blacksnake200212-del/FYP_2026/hardware_docs/sdas_corrected_circuit_schematic.jpg

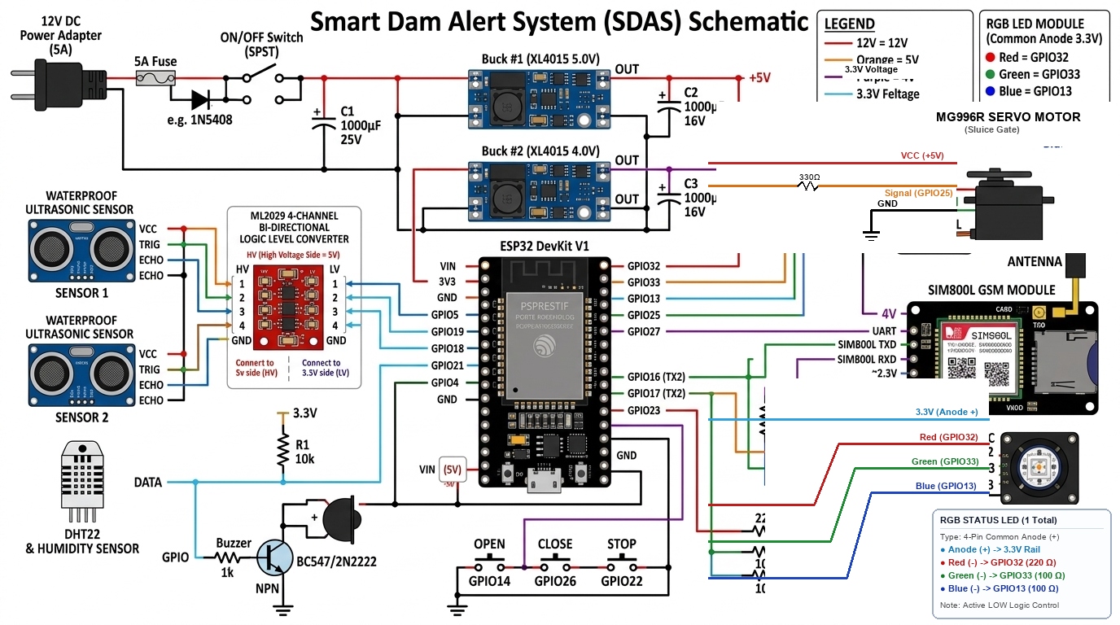
hardware_docs/sdas_corrected_circuit_schematic.jpg
