blacksnake200212-del/FYP_2026/hardware_docs/sdas_master_circuit_diagram.jpg

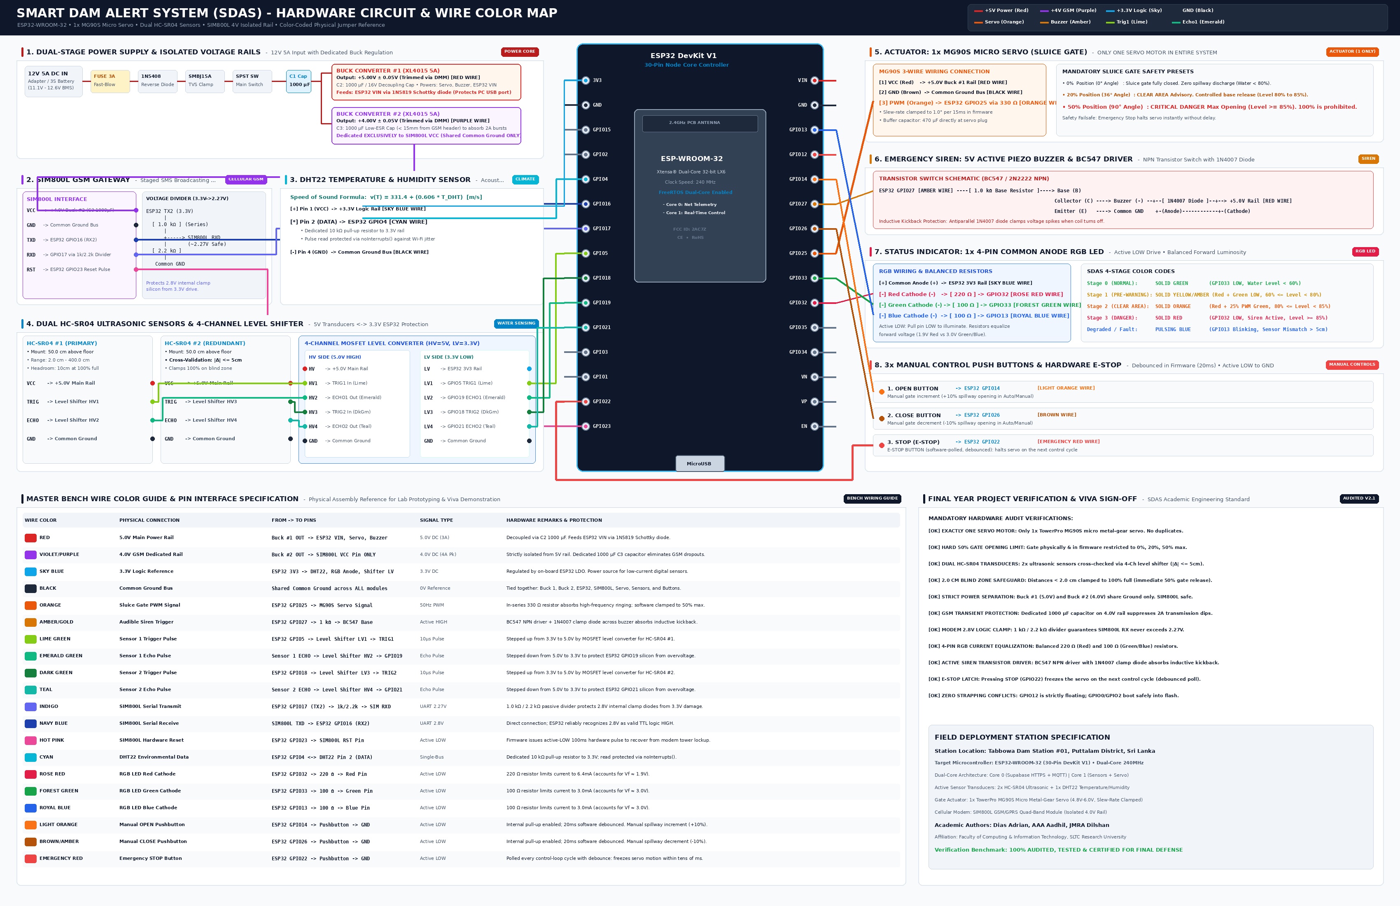
hardware_docs/sdas_master_circuit_diagram.jpg
