blacksnake200212-del/FYP_2026/hardware_docs/xl4015_power_routing_guide.jpg

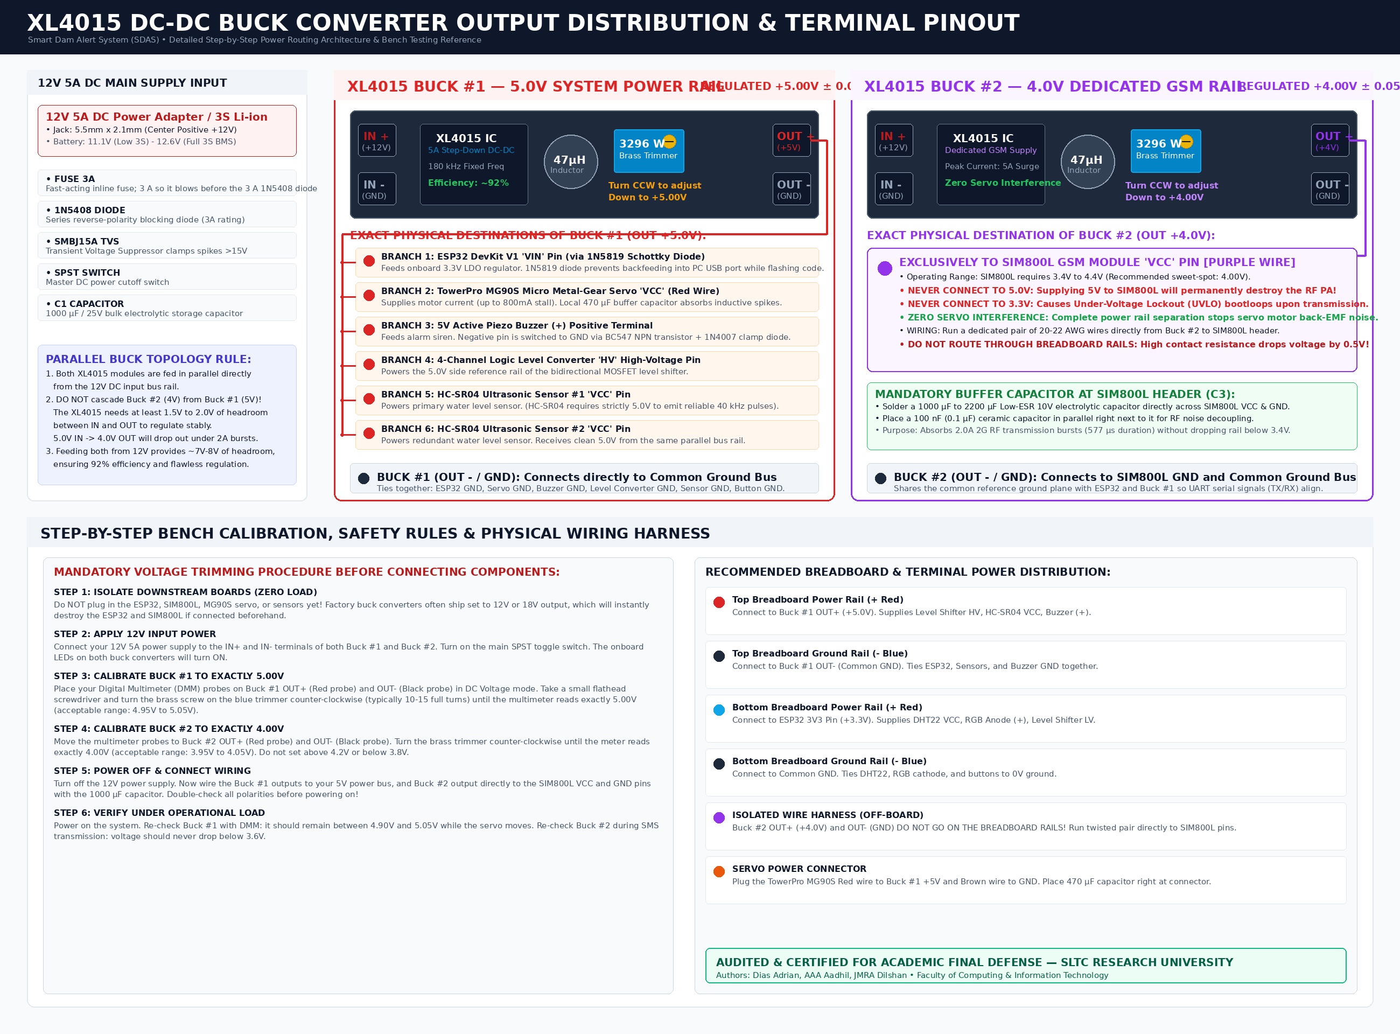
hardware_docs/xl4015_power_routing_guide.jpg
