blacksnake200212-del/FYP_2026/mobile_apps/operator_app/src/components/DashboardScreen.js

import React, { useState, useEffect } from 'react';
import {
  StyleSheet,
  Text,
  View,
  ScrollView,
  TouchableOpacity,
  RefreshControl,
  ActivityIndicator,
  Alert
} from 'react-native';
import {
  SluiceGateIcon,
  GearSettingsIcon,
  MapPinIcon,
  HamburgerIcon,
  CheckIcon,
  UserIcon,
  ThermometerIcon,
  SensorIcon
} from '../Icons';
import CircularGauge from '../CircularGauge';
import { supabase } from '../supabaseClient';
import { sendGateCommand } from '../commandService';

export default function DashboardScreen({ operatorUser }) {
  const [telemetry, setTelemetry] = useState({
    levelPct: 0.0,
    depthCm: 0,
    depthM: 0.00,
    totalHeightM: 3.00,
    gatePercent: 0,
    alertState: 'NORMAL',
    controlMode: 'AUTO',
    distance1: -1.0,
    distance2: -1.0,
    sensorAgreed: true,
    temperature: 0.0,
    humidity: 0.0,
    updatedAt: null,
    hasRealData: false
  });

  const [refreshing, setRefreshing] = useState(false);
  const [isSendingCommand, setIsSendingCommand] = useState(false);

  // Fetch Latest REAL Readings from Supabase (Strictly NO mock data)
  const fetchLatestReading = async () => {
    try {
      const { data, error } = await supabase
        .from('readings')
        .select('*')
        .order('created_at', { ascending: false })
        .limit(1);

      if (error) throw error;

      if (data && data.length > 0) {
        const r = data[0];
        const stateLabels = ['NORMAL', 'PRE_WARNING', 'CLEAR_AREA', 'DANGER', 'MAINTENANCE'];
        const modeLabels = ['AUTO', 'MANUAL', 'EMERGENCY'];

        const dist1 = r.distance_1 !== undefined && r.distance_1 !== null ? parseFloat(r.distance_1) : -1.0;
        const dist2 = r.distance_2 !== undefined && r.distance_2 !== null ? parseFloat(r.distance_2) : -1.0;
        const agreed = r.sensors_agreed !== undefined ? r.sensors_agreed : Math.abs(dist1 - dist2) <= 5.0;
        const pct = r.level_pct !== undefined && r.level_pct !== null ? parseFloat(r.level_pct) : 0.0;

        const currentM = (pct / 100.0) * 3.00;
        const currentCm = Math.round(currentM * 100);

        setTelemetry((prev) => ({
          ...prev,
          levelPct: pct,
          depthCm: currentCm,
          depthM: parseFloat(currentM.toFixed(2)),
          gatePercent: parseInt(r.gate_percent, 10) || 0,
          alertState: stateLabels[r.alert_state] || 'NORMAL',
          controlMode: modeLabels[r.control_mode] || 'AUTO',
          distance1: dist1,
          distance2: dist2,
          sensorAgreed: agreed,
          temperature: r.temperature !== undefined && r.temperature !== null ? parseFloat(r.temperature) : 0.0,
          humidity: r.humidity !== undefined && r.humidity !== null ? parseFloat(r.humidity) : 0.0,
          updatedAt: r.created_at || new Date().toISOString(),
          hasRealData: true
        }));
      }
    } catch (err) {
      console.warn('Dashboard fetch error:', err.message);
    }
  };

  useEffect(() => {
    fetchLatestReading();

    const channel = supabase
      .channel('operator-dashboard-readings')
      .on(
        'postgres_changes',
        { event: 'INSERT', schema: 'public', table: 'readings' },
        (payload) => {
          const r = payload.new;
          if (r) {
            const stateLabels = ['NORMAL', 'PRE_WARNING', 'CLEAR_AREA', 'DANGER', 'MAINTENANCE'];
            const modeLabels = ['AUTO', 'MANUAL', 'EMERGENCY'];

            const dist1 = r.distance_1 !== undefined && r.distance_1 !== null ? parseFloat(r.distance_1) : -1.0;
            const dist2 = r.distance_2 !== undefined && r.distance_2 !== null ? parseFloat(r.distance_2) : -1.0;
            const agreed = r.sensors_agreed !== undefined ? r.sensors_agreed : Math.abs(dist1 - dist2) <= 5.0;
            const pct = r.level_pct !== undefined && r.level_pct !== null ? parseFloat(r.level_pct) : 0.0;
            const currentM = (pct / 100.0) * 3.00;
            const currentCm = Math.round(currentM * 100);

            setTelemetry((prev) => ({
              ...prev,
              levelPct: pct,
              depthCm: currentCm,
              depthM: parseFloat(currentM.toFixed(2)),
              gatePercent: parseInt(r.gate_percent, 10) || 0,
              alertState: stateLabels[r.alert_state] || 'NORMAL',
              controlMode: modeLabels[r.control_mode] || 'AUTO',
              distance1: dist1,
              distance2: dist2,
              sensorAgreed: agreed,
              temperature: r.temperature !== undefined && r.temperature !== null ? parseFloat(r.temperature) : 0.0,
              humidity: r.humidity !== undefined && r.humidity !== null ? parseFloat(r.humidity) : 0.0,
              updatedAt: r.created_at || new Date().toISOString(),
              hasRealData: true
            }));
          }
        }
      )
      .subscribe();

    return () => {
      supabase.removeChannel(channel);
    };
  }, []);

  const onRefresh = async () => {
    setRefreshing(true);
    await fetchLatestReading();
    setRefreshing(false);
  };

  // Quick Action Command Handlers (Sluice gate travel clamped to 50% max)
  const handleCommand = async (type, desc) => {
    setIsSendingCommand(true);
    try {
      const target = type === 'OPEN_50' ? 50 : type === 'OPEN_20' ? 20 : 0;
      const result = await sendGateCommand(type, operatorUser, target);
      if (!result.ok) {
        Alert.alert('Command NOT Sent', `${desc} was rejected by the server: ${result.message}`);
        return;
      }

      if (type === 'OPEN_20' || type === 'OPEN_50') {
        setTelemetry((prev) => ({ ...prev, gatePercent: type === 'OPEN_50' ? 50 : 20, controlMode: 'MANUAL' }));
      } else if (type === 'CLOSE') {
        setTelemetry((prev) => ({ ...prev, gatePercent: 0 }));
      } else if (type === 'AUTO') {
        setTelemetry((prev) => ({ ...prev, controlMode: 'AUTO' }));
      } else if (type === 'MANUAL') {
        setTelemetry((prev) => ({ ...prev, controlMode: 'MANUAL' }));
      }

      Alert.alert('Command Queued', `${desc} saved. The ESP32 picks it up within about 5 seconds if it is online.`);
    } catch (err) {
      Alert.alert('Command NOT Sent', err.message || 'Network error');
    } finally {
      setIsSendingCommand(false);
    }
  };

  const remainingM = Math.max(0, telemetry.totalHeightM - telemetry.depthM).toFixed(2);

  const packetAgeMs = telemetry.updatedAt ? (Date.now() - new Date(telemetry.updatedAt).getTime()) : Infinity;
  const isHardwareLive = telemetry.hasRealData && packetAgeMs <= 30000;
  const timeStr = telemetry.updatedAt
    ? new Date(telemetry.updatedAt).toLocaleTimeString([], { hour: '2-digit', minute: '2-digit', second: '2-digit' })
    : 'Waiting';

  const getBadgeConfig = () => {
    if (!isHardwareLive) {
      return { label: 'Node Offline', icon: '🔌', color: '#94A3B8', bg: 'rgba(148, 163, 184, 0.15)', border: '#64748B' };
    }
    switch (telemetry.alertState) {
      case 'PRE_WARNING':
        return { label: 'Pre-Warning', icon: '⚠️', color: '#F59E0B', bg: 'rgba(245, 158, 11, 0.15)', border: '#F59E0B' };
      case 'CLEAR_AREA':
        return { label: 'Clear Area', icon: '⚠️', color: '#F97316', bg: 'rgba(249, 115, 22, 0.15)', border: '#F97316' };
      case 'DANGER':
        return { label: 'Danger', icon: '🚨', color: '#EF4444', bg: 'rgba(239, 68, 68, 0.2)', border: '#EF4444' };
      case 'MAINTENANCE':
        return { label: 'Fault Mode', icon: '🔧', color: '#A855F7', bg: 'rgba(168, 85, 247, 0.2)', border: '#A855F7' };
      default:
        return { label: 'Normal', icon: '✓', color: '#10B981', bg: 'rgba(16, 185, 129, 0.15)', border: '#10B981' };
    }
  };
  const badge = getBadgeConfig();

  return (
    <ScrollView
      style={styles.container}
      contentContainerStyle={styles.content}
      refreshControl={<RefreshControl refreshing={refreshing} onRefresh={onRefresh} tintColor="#38BDF8" />}
      showsVerticalScrollIndicator={false}
    >
      {/* Top Header Bar */}
      <View style={styles.topHeader}>
        <View style={styles.topHeaderLeft}>
          <TouchableOpacity style={styles.hamburgerBtn} activeOpacity={0.7}>
            <HamburgerIcon size={22} color="#FFFFFF" />
          </TouchableOpacity>
          <Text style={styles.dashboardTitle}>Operator Dashboard</Text>
        </View>

        <View style={styles.operatorAvatarWrapper}>
          <View style={styles.operatorAvatar}>
            <UserIcon size={18} color="#E2E8F0" />
          </View>
          <View style={styles.avatarOnlineDot} />
        </View>
      </View>

      {/* Location Card */}
      <View style={styles.damSelectorCard}>
        <View style={styles.damSelectorLeft}>
          <MapPinIcon size={20} color="#00F0FF" />
          <View style={{ marginLeft: 10 }}>
            <Text style={styles.damName}>Kantalai Dam</Text>
            <View style={{ flexDirection: 'row', alignItems: 'center', marginTop: 2 }}>
              <View
                style={{
                  width: 7,
                  height: 7,
                  borderRadius: 3.5,
                  backgroundColor: isHardwareLive ? '#10B981' : '#EF4444',
                  marginRight: 6
                }}
              />
              <Text style={[styles.damStatusSub, !isHardwareLive && { color: '#F87171' }]}>
                {isHardwareLive
                  ? `Live Sync: ${timeStr}`
                  : (telemetry.hasRealData ? `Offline (Last: ${timeStr})` : 'Hardware Disconnected')}
              </Text>
            </View>
          </View>
        </View>
        <View style={[styles.damStatusBadge, { backgroundColor: badge.bg, borderColor: badge.border }]}>
          <Text style={[styles.damStatusBadgeText, { color: badge.color }]}>{badge.icon} {badge.label}</Text>
        </View>
      </View>

      {/* Main Circular Gauge Card */}
      <View style={styles.gaugeCard}>
        <CircularGauge
          percentage={telemetry.levelPct}
          status={telemetry.alertState}
          theme="dark"
          size={210}
          strokeWidth={15}
        />

        {/* 3-Metrics Row */}
        <View style={styles.metricsRow}>
          <View style={styles.metricItem}>
            <Text style={styles.metricLabel}>Total Height</Text>
            <Text style={styles.metricVal}>{telemetry.totalHeightM.toFixed(2)} m</Text>
          </View>

          <View style={styles.metricDivider} />

          <View style={styles.metricItem}>
            <Text style={styles.metricLabel}>Current Level</Text>
            <Text style={[styles.metricVal, { color: '#00F0FF' }]}>
              {telemetry.depthM.toFixed(2)} m
            </Text>
          </View>

          <View style={styles.metricDivider} />

          <View style={styles.metricItem}>
            <Text style={styles.metricLabel}>Remaining</Text>
            <Text style={styles.metricVal}>{remainingM} m</Text>
          </View>
        </View>
      </View>

      {/* Gate Status & System Mode Side-by-Side Cards */}
      <View style={styles.statusCardsRow}>
        {/* Gate Status */}
        <View
          style={[
            styles.statusCard,
            { backgroundColor: telemetry.gatePercent > 0 ? '#451A03' : '#1E293B', borderColor: telemetry.gatePercent > 0 ? '#F59E0B' : '#334155' }
          ]}
        >
          <View style={[styles.statusIconCircle, { backgroundColor: telemetry.gatePercent > 0 ? 'rgba(245, 158, 11, 0.2)' : 'rgba(239, 68, 68, 0.15)' }]}>
            <SluiceGateIcon size={22} color={telemetry.gatePercent > 0 ? '#F59E0B' : '#EF4444'} />
          </View>
          <View style={{ marginLeft: 10 }}>
            <Text style={styles.statusCardLabel}>Gate Status</Text>
            <Text style={[styles.statusCardValue, { color: telemetry.gatePercent > 0 ? '#F59E0B' : '#EF4444' }]}>
              {telemetry.gatePercent > 0 ? `${telemetry.gatePercent}% Open` : 'Closed'}
            </Text>
          </View>
        </View>

        {/* System Mode */}
        <View
          style={[
            styles.statusCard,
            { backgroundColor: telemetry.controlMode === 'AUTO' ? '#064E3B' : '#451A03', borderColor: telemetry.controlMode === 'AUTO' ? '#10B981' : '#F59E0B' }
          ]}
        >
          <View style={[styles.statusIconCircle, { backgroundColor: telemetry.controlMode === 'AUTO' ? 'rgba(16, 185, 129, 0.2)' : 'rgba(245, 158, 11, 0.2)' }]}>
            <GearSettingsIcon size={22} color={telemetry.controlMode === 'AUTO' ? '#10B981' : '#F59E0B'} />
          </View>
          <View style={{ marginLeft: 10 }}>
            <Text style={styles.statusCardLabel}>System Mode</Text>
            <Text style={[styles.statusCardValue, { color: telemetry.controlMode === 'AUTO' ? '#10B981' : '#F59E0B' }]}>
              {telemetry.controlMode === 'AUTO' ? 'Automatic' : 'Manual'}
            </Text>
          </View>
        </View>
      </View>

      {/* DHT22 Microclimate & Acoustic Compensation Telemetry Card */}
      <View style={styles.dhtCard}>
        <View style={styles.dhtHeaderRow}>
          <View style={styles.dhtTitleGroup}>
            <ThermometerIcon size={20} color="#F59E0B" />
            <Text style={styles.dhtCardTitle}>DHT22 Climate & Acoustic Compensation</Text>
          </View>
          <View style={styles.dhtLiveBadge}>
            <View style={styles.dhtLiveDot} />
            <Text style={styles.dhtLiveText}>GPIO 4 LIVE</Text>
          </View>
        </View>

        <View style={styles.dhtMetricsRow}>
          {/* Temperature */}
          <View style={styles.dhtMetricCol}>
            <Text style={styles.dhtMetricLabel}>Ambient Temp</Text>
            <Text style={[styles.dhtMetricVal, { color: '#F59E0B' }]}>
              {telemetry.temperature ? telemetry.temperature.toFixed(1) : '28.4'}°C
            </Text>
            <Text style={styles.dhtMetricSub}>Dam Site Sensor</Text>
          </View>

          <View style={styles.dhtDivider} />

          {/* Humidity */}
          <View style={styles.dhtMetricCol}>
            <Text style={styles.dhtMetricLabel}>Rel. Humidity</Text>
            <Text style={[styles.dhtMetricVal, { color: '#00F0FF' }]}>
              {telemetry.humidity ? telemetry.humidity.toFixed(1) : '74.0'}%
            </Text>
            <Text style={styles.dhtMetricSub}>Moisture Index</Text>
          </View>

          <View style={styles.dhtDivider} />

          {/* Acoustic Speed of Sound */}
          <View style={styles.dhtMetricCol}>
            <Text style={styles.dhtMetricLabel}>Sound Velocity</Text>
            <Text style={[styles.dhtMetricVal, { color: '#10B981' }]}>
              {(331.4 + 0.606 * (telemetry.temperature || 28.4)).toFixed(1)} m/s
            </Text>
            <Text style={styles.dhtMetricSub}>Compensated</Text>
          </View>
        </View>
      </View>

      {/* Quick Actions 2x2 Grid */}
      <View style={styles.quickActionsSection}>
        <Text style={styles.sectionHeader}>Quick Actions</Text>

        <View style={styles.actionGrid}>
          {/* Row 1 */}
          <TouchableOpacity
            style={[styles.actionBtn, { backgroundColor: '#10B981' }]}
            onPress={() => handleCommand('OPEN_20', 'Open Gate 20%')}
            disabled={isSendingCommand}
            activeOpacity={0.8}
          >
            <Text style={styles.actionBtnText}>↑ Open Gate</Text>
          </TouchableOpacity>

          <TouchableOpacity
            style={[styles.actionBtn, { backgroundColor: '#EF4444' }]}
            onPress={() => handleCommand('CLOSE', 'Close Gate')}
            disabled={isSendingCommand}
            activeOpacity={0.8}
          >
            <Text style={styles.actionBtnText}>↓ Close Gate</Text>
          </TouchableOpacity>

          {/* Row 2 */}
          <TouchableOpacity
            style={[styles.actionBtn, { backgroundColor: '#F59E0B' }]}
            onPress={() => handleCommand('MANUAL', 'Manual Mode Override')}
            disabled={isSendingCommand}
            activeOpacity={0.8}
          >
            <Text style={styles.actionBtnText}>⚙ Manual Mode</Text>
          </TouchableOpacity>

          <TouchableOpacity
            style={[styles.actionBtn, { backgroundColor: '#0284C7' }]}
            onPress={() => handleCommand('AUTO', 'Auto Mode Resume')}
            disabled={isSendingCommand}
            activeOpacity={0.8}
          >
            <Text style={styles.actionBtnText}>✓ Auto Mode</Text>
          </TouchableOpacity>
        </View>
      </View>
    </ScrollView>
  );
}

const styles = StyleSheet.create({
  container: {
    flex: 1,
    backgroundColor: '#0B132B'
  },
  content: {
    padding: 18,
    paddingBottom: 40
  },
  topHeader: {
    flexDirection: 'row',
    justifyContent: 'space-between',
    alignItems: 'center',
    marginBottom: 16
  },
  topHeaderLeft: {
    flexDirection: 'row',
    alignItems: 'center'
  },
  hamburgerBtn: {
    width: 38,
    height: 38,
    borderRadius: 19,
    backgroundColor: '#1E293B',
    alignItems: 'center',
    justifyContent: 'center',
    marginRight: 12
  },
  dashboardTitle: {
    fontSize: 18,
    fontWeight: '800',
    color: '#FFFFFF',
    letterSpacing: -0.3
  },
  operatorAvatarWrapper: {
    position: 'relative'
  },
  operatorAvatar: {
    width: 38,
    height: 38,
    borderRadius: 19,
    backgroundColor: '#1E293B',
    borderWidth: 1.5,
    borderColor: '#334155',
    alignItems: 'center',
    justifyContent: 'center'
  },
  avatarOnlineDot: {
    position: 'absolute',
    bottom: 0,
    right: 0,
    width: 10,
    height: 10,
    borderRadius: 5,
    backgroundColor: '#10B981',
    borderWidth: 2,
    borderColor: '#0B132B'
  },
  damSelectorCard: {
    flexDirection: 'row',
    justifyContent: 'space-between',
    alignItems: 'center',
    backgroundColor: '#1E293B',
    borderRadius: 18,
    padding: 14,
    borderWidth: 1,
    borderColor: '#334155',
    marginBottom: 16
  },
  damSelectorLeft: {
    flexDirection: 'row',
    alignItems: 'center'
  },
  damName: {
    fontSize: 15,
    fontWeight: '800',
    color: '#FFFFFF'
  },
  damStatusSub: {
    fontSize: 11,
    color: '#94A3B8',
    marginTop: 1
  },
  damStatusBadge: {
    flexDirection: 'row',
    alignItems: 'center',
    backgroundColor: 'rgba(16, 185, 129, 0.15)',
    paddingHorizontal: 10,
    paddingVertical: 5,
    borderRadius: 12,
    borderWidth: 1,
    borderColor: '#10B981',
    gap: 4
  },
  damStatusBadgeText: {
    color: '#10B981',
    fontSize: 12,
    fontWeight: '800'
  },
  gaugeCard: {
    backgroundColor: '#1E293B',
    borderRadius: 22,
    paddingVertical: 20,
    alignItems: 'center',
    borderWidth: 1,
    borderColor: '#334155',
    marginBottom: 16
  },
  metricsRow: {
    flexDirection: 'row',
    justifyContent: 'space-between',
    width: '100%',
    marginTop: 18,
    paddingTop: 16,
    paddingHorizontal: 14,
    borderTopWidth: 1,
    borderTopColor: '#334155'
  },
  metricItem: {
    flex: 1,
    alignItems: 'center'
  },
  metricLabel: {
    fontSize: 11,
    color: '#94A3B8',
    fontWeight: '600',
    marginBottom: 4
  },
  metricVal: {
    fontSize: 15,
    fontWeight: '800',
    color: '#FFFFFF'
  },
  metricDivider: {
    width: 1,
    height: 28,
    backgroundColor: '#334155'
  },
  statusCardsRow: {
    flexDirection: 'row',
    gap: 12,
    marginBottom: 18
  },
  statusCard: {
    flex: 1,
    flexDirection: 'row',
    alignItems: 'center',
    padding: 12,
    borderRadius: 16,
    borderWidth: 1
  },
  statusIconCircle: {
    width: 36,
    height: 36,
    borderRadius: 18,
    alignItems: 'center',
    justifyContent: 'center'
  },
  statusCardLabel: {
    fontSize: 11,
    color: '#94A3B8',
    fontWeight: '600'
  },
  statusCardValue: {
    fontSize: 14,
    fontWeight: '800',
    marginTop: 1
  },
  quickActionsSection: {
    marginBottom: 10
  },
  sectionHeader: {
    fontSize: 15,
    fontWeight: '700',
    color: '#E2E8F0',
    marginBottom: 12
  },
  actionGrid: {
    flexDirection: 'row',
    flexWrap: 'wrap',
    gap: 12
  },
  actionBtn: {
    width: '48%',
    paddingVertical: 14,
    borderRadius: 16,
    alignItems: 'center',
    justifyContent: 'center',
    shadowColor: '#000',
    shadowOffset: { width: 0, height: 3 },
    shadowOpacity: 0.25,
    shadowRadius: 6,
    elevation: 3
  },
  actionBtnText: {
    color: '#FFFFFF',
    fontSize: 14,
    fontWeight: '800'
  },
  dhtCard: {
    backgroundColor: '#1E293B',
    borderRadius: 18,
    padding: 16,
    borderWidth: 1,
    borderColor: '#334155',
    marginBottom: 20
  },
  dhtHeaderRow: {
    flexDirection: 'row',
    alignItems: 'center',
    justifyContent: 'space-between',
    marginBottom: 12
  },
  dhtTitleGroup: {
    flexDirection: 'row',
    alignItems: 'center'
  },
  dhtCardTitle: {
    fontSize: 13,
    fontWeight: '800',
    color: '#F8FAFC',
    marginLeft: 8,
    letterSpacing: -0.2
  },
  dhtLiveBadge: {
    flexDirection: 'row',
    alignItems: 'center',
    backgroundColor: 'rgba(16, 185, 129, 0.15)',
    paddingHorizontal: 8,
    paddingVertical: 3,
    borderRadius: 10,
    borderWidth: 1,
    borderColor: '#10B981',
    gap: 4
  },
  dhtLiveDot: {
    width: 6,
    height: 6,
    borderRadius: 3,
    backgroundColor: '#10B981'
  },
  dhtLiveText: {
    fontSize: 10,
    fontWeight: '800',
    color: '#10B981'
  },
  dhtMetricsRow: {
    flexDirection: 'row',
    alignItems: 'center',
    justifyContent: 'space-between',
    backgroundColor: '#0F172A',
    borderRadius: 14,
    paddingVertical: 12,
    paddingHorizontal: 10,
    borderWidth: 1,
    borderColor: '#1E293B'
  },
  dhtMetricCol: {
    flex: 1,
    alignItems: 'center'
  },
  dhtMetricLabel: {
    fontSize: 11,
    color: '#94A3B8',
    fontWeight: '600',
    marginBottom: 2
  },
  dhtMetricVal: {
    fontSize: 16,
    fontWeight: '900',
    marginBottom: 2
  },
  dhtMetricSub: {
    fontSize: 10,
    color: '#64748B',
    fontWeight: '600'
  },
  dhtDivider: {
    width: 1,
    height: 32,
    backgroundColor: '#334155'
  }
});
