blacksnake200212-del/FYP_2026/firmware/SDAS_ESP32_Firmware/sensors.cpp

#include "sensors.h"
#include <Preferences.h>

SensorManager::SensorManager() 
    : activeSensorCount(ACTIVE_ULTRASONIC_COUNT),
      previousWaterLevelCm(0.0f), previousSampleTimeMs(0),
      consecutiveFailCycles(0), lastDhtOkMs(0) {
    memset(&currentData, 0, sizeof(SensorData));
}

void SensorManager::begin() {
    pinMode(PIN_TRIG_1, OUTPUT);
    pinMode(PIN_ECHO_1, INPUT);
    pinMode(PIN_TRIG_2, OUTPUT);
    pinMode(PIN_ECHO_2, INPUT);
    
    digitalWrite(PIN_TRIG_1, LOW);
    digitalWrite(PIN_TRIG_2, LOW);
    
    pinMode(PIN_DHT, INPUT_PULLUP);
    
    // Load saved sensor count configuration from Flash
    Preferences prefs;
    prefs.begin("sdas_sens", false);
    activeSensorCount = prefs.getUChar("sens_cnt", ACTIVE_ULTRASONIC_COUNT);
    // When ACTIVE_ULTRASONIC_COUNT is set to 2, automatically activate dual sensor voting mode
    if (ACTIVE_ULTRASONIC_COUNT >= 2) {
        activeSensorCount = 2;
        prefs.putUChar("sens_cnt", 2);
    }
    prefs.end();
    
    Serial.printf("[SENSORS] Active Ultrasonic Sensors: %d (%s)\n",
        activeSensorCount,
        activeSensorCount == 1 ? "Single Sensor Mode - Primary HC-SR04 on GPIO5/19" : "Dual Sensor Voting Mode - S1(GPIO5/19) + S2(GPIO18/21)");
    
    // Default values used ONLY for speed-of-sound compensation until the DHT22 answers.
    // FIX: these used to be uploaded as if they were real readings (every row in the
    // Google Sheet export showed exactly 28 C / 75 %). dht_valid now tells the truth.
    currentData.temperature_c = 28.0f;
    currentData.humidity_pct = 75.0f;
    currentData.dht_valid = false;
    currentData.speed_of_sound_mps = calculateSpeedOfSound(28.0f);
}

void SensorManager::setSensorCount(uint8_t count) {
    activeSensorCount = (count >= 2) ? 2 : 1;
    Preferences prefs;
    prefs.begin("sdas_sens", false);
    prefs.putUChar("sens_cnt", activeSensorCount);
    prefs.end();
    Serial.printf("[SENSORS] Sensor count set to: %d (%s) - Saved to Flash!\n",
        activeSensorCount,
        activeSensorCount == 1 ? "Single Sensor #1 Primary" : "Dual Sensor Voting");
}

float SensorManager::calculateSpeedOfSound(float tempC) {
    // Standard acoustic relationship: v = 331.4 + 0.606 * T (m/s)
    return 331.4f + (0.606f * tempC);
}

// Low-overhead DHT22 bit-banging driver for field resilience
void SensorManager::readDHTSensors() {
    // FIX: mark the DHT22 invalid if there has been no good reading for DHT_STALE_MS
    if (millis() - lastDhtOkMs > DHT_STALE_MS) {
        currentData.dht_valid = false;
    }
    uint8_t data[5] = {0, 0, 0, 0, 0};
    
    // Wakeup sequence: Pull line LOW for >= 1 ms, then HIGH for 30 us
    pinMode(PIN_DHT, OUTPUT);
    digitalWrite(PIN_DHT, LOW);
    delay(2);
    digitalWrite(PIN_DHT, HIGH);
    delayMicroseconds(30);
    pinMode(PIN_DHT, INPUT_PULLUP);
    
    // Await sensor response (80us LOW + 80us HIGH)
    unsigned long timeout = micros() + 200;
    while (digitalRead(PIN_DHT) == HIGH) {
        if (micros() > timeout) return; // Retain previous valid reading
    }
    timeout = micros() + 200;
    while (digitalRead(PIN_DHT) == LOW) {
        if (micros() > timeout) return;
    }
    timeout = micros() + 200;
    while (digitalRead(PIN_DHT) == HIGH) {
        if (micros() > timeout) return;
    }
    
    // Read 40 bits (5 bytes) with interrupt protection
    noInterrupts();
    for (int i = 0; i < 40; i++) {
        timeout = micros() + 100;
        while (digitalRead(PIN_DHT) == LOW) {
            if (micros() > timeout) {
                interrupts();
                return;
            }
        }
        unsigned long tStart = micros();
        timeout = micros() + 150;
        while (digitalRead(PIN_DHT) == HIGH) {
            if (micros() > timeout) {
                interrupts();
                return;
            }
        }
        // If pulse width > 40 us, bit is 1, else 0
        if ((micros() - tStart) > 40) {
            data[i / 8] |= (1 << (7 - (i % 8)));
        }
    }
    interrupts();
    
    // Checksum verification
    if (data[4] == ((data[0] + data[1] + data[2] + data[3]) & 0xFF)) {
        float rawHumidity = ((data[0] << 8) | data[1]) * 0.1f;
        int16_t rawTemp = ((data[2] & 0x7F) << 8) | data[3];
        if (data[2] & 0x80) rawTemp = -rawTemp;
        float finalTemp = rawTemp * 0.1f;
        
        if (finalTemp >= -10.0f && finalTemp <= 65.0f && rawHumidity >= 5.0f && rawHumidity <= 100.0f) {
            currentData.temperature_c = finalTemp;
            currentData.humidity_pct = rawHumidity;
            currentData.speed_of_sound_mps = calculateSpeedOfSound(finalTemp);
            currentData.dht_valid = true;
            lastDhtOkMs = millis();
        }
    }
}

float SensorManager::measureSingleUltrasonic(uint8_t trigPin, uint8_t echoPin, float speedOfSound) {
    // Clear trigger line cleanly
    digitalWrite(trigPin, LOW);
    delayMicroseconds(5);
    
    // 15 microsecond HIGH pulse to activate HC-SR04 burst
    // (15us ensures 100% reliable trigger edge propagation across level shifters)
    digitalWrite(trigPin, HIGH);
    delayMicroseconds(15);
    digitalWrite(trigPin, LOW);
    
    // Measure echo pulse width (timeout 24,000 us ~= 4.1 meters, covers full room/tank range)
    unsigned long durationUs = pulseIn(echoPin, HIGH, 24000UL);
    
    if (durationUs == 0) {
        return -1.0f; // Timeout / No echo returned
    }
    
    // Distance in cm = (Time in s * Speed in cm/s) / 2
    float distanceCm = (durationUs * 1e-6f * (speedOfSound * 100.0f)) / 2.0f;
    return distanceCm;
}

void SensorManager::testRawPing() {
    Serial.println("\n=======================================================");
    Serial.println("     RAW ULTRASONIC HARDWARE PING DIAGNOSTIC");
    Serial.println("=======================================================");
    
    // Sensor 1: GPIO 5 (Trig) / GPIO 19 (Echo)
    digitalWrite(PIN_TRIG_1, LOW);
    delayMicroseconds(5);
    digitalWrite(PIN_TRIG_1, HIGH);
    delayMicroseconds(15);
    digitalWrite(PIN_TRIG_1, LOW);
    unsigned long dur1 = pulseIn(PIN_ECHO_1, HIGH, 25000UL);
    float d1 = (dur1 > 0) ? (dur1 * 1e-6f * (currentData.speed_of_sound_mps * 100.0f)) / 2.0f : -1.0f;
    
    delay(50);
    
    // Sensor 2: GPIO 18 (Trig) / GPIO 21 (Echo)
    digitalWrite(PIN_TRIG_2, LOW);
    delayMicroseconds(5);
    digitalWrite(PIN_TRIG_2, HIGH);
    delayMicroseconds(15);
    digitalWrite(PIN_TRIG_2, LOW);
    unsigned long dur2 = pulseIn(PIN_ECHO_2, HIGH, 25000UL);
    float d2 = (dur2 > 0) ? (dur2 * 1e-6f * (currentData.speed_of_sound_mps * 100.0f)) / 2.0f : -1.0f;
    
    Serial.printf("Sensor 1 (Trig 5 / Echo 19):   Raw = %lu us -> %.1f cm [%s]\n",
        dur1, d1, dur1 > 0 ? "ECHO OK" : "TIMEOUT (0 us)");
    Serial.printf("Sensor 2 (Trig 18 / Echo 21): Raw = %lu us -> %.1f cm [%s]\n",
        dur2, d2, dur2 > 0 ? "ECHO OK" : "TIMEOUT (0 us)");
    if (dur1 == 0 && dur2 > 0) {
        Serial.println("\n[DIAGNOSTIC] Sensor 2 is ECHOING, but Sensor 1 is TIMING OUT!");
        Serial.println("Common causes for Sensor 1:");
        Serial.println("  1. Level Converter HV1/LV1 or HV2/LV2 channel loose or miswired.");
        Serial.println("  2. Direct TRIG Recommendation: Wire Sensor 1 TRIG directly to GPIO 5!");
        Serial.println("     (ESP32 3.3V triggers HC-SR04 directly with no level shifter needed)");
        Serial.println("  3. Only ECHO needs level shifting: Sensor 1 ECHO -> Level Converter HV -> LV -> GPIO 19.");
    }
    Serial.println("=======================================================\n");
}

// 3-Sample Median Filter to reject acoustic spikes, multipath glitches, and dropouts
float SensorManager::measureFilteredUltrasonic(uint8_t trigPin, uint8_t echoPin, float speedOfSound) {
    float samples[3];
    int validCount = 0;
    int blindCount = 0;
    
    for (int i = 0; i < 3; i++) {
        float d = measureSingleUltrasonic(trigPin, echoPin, speedOfSound);
        if (d >= 3.0f && d <= SENSOR_MAX_VALID_DIST_CM) {
            samples[validCount++] = d;
        } else if (d > 0.0f && d < 3.0f) {
            blindCount++; // echo inside the HC-SR04 blind zone: water is AT the sensor
        }
        delay(12);
    }
    
    if (validCount == 0) {
        // FIX: water inside the blind zone means a FULL tank, not "no reading".
        if (blindCount >= 2) return SENSOR_MIN_VALID_DIST_CM;
        return -1.0f; // No echo at all = sensor fault (wiring, power, or out of range)
    }
    
    // Simple sort for median
    for (int i = 0; i < validCount - 1; i++) {
        for (int j = i + 1; j < validCount; j++) {
            if (samples[i] > samples[j]) {
                float tmp = samples[i];
                samples[i] = samples[j];
                samples[j] = tmp;
            }
        }
    }
    
    return samples[validCount / 2];
}

SensorData SensorManager::sampleAndVerify() {
    unsigned long now = millis();
    readDHTSensors();
    
    // --- Step 1: Ultrasonic Ping Sequence with 3-Sample Median Filter ---
    // Trigger Sensor 1 (Primary on GPIO5/19)
    float d1 = measureFilteredUltrasonic(PIN_TRIG_1, PIN_ECHO_1, currentData.speed_of_sound_mps);
    float d2 = -1.0f;
    
    // Only ping Sensor 2 if dual-sensor mode is enabled
    if (activeSensorCount >= 2) {
        delay(40); // Acoustic blanking interval
        d2 = measureFilteredUltrasonic(PIN_TRIG_2, PIN_ECHO_2, currentData.speed_of_sound_mps);
    }
    
    currentData.raw_dist_1_cm = d1;
    currentData.raw_dist_2_cm = d2;
    currentData.timestamp_ms = now;
    
    // --- Step 2: Physical Range Plausibility ---
    // FIX (safety-critical): a timeout (-1) used to be replaced by 50 cm and marked VALID,
    // i.e. "tank empty, 0%". A disconnected sensor, a dead 5V rail, or water covering the
    // sensor therefore reported a safe EMPTY tank, and AUTO mode CLOSED the gate.
    // The sensor tank floor is only 50 cm away, so a real HC-SR04 always gets an echo:
    // no echo is now treated as a sensor fault.
    currentData.sensor_1_valid = (d1 >= SENSOR_MIN_VALID_DIST_CM && d1 <= SENSOR_MAX_VALID_DIST_CM);
    
    if (activeSensorCount >= 2) {
        currentData.sensor_2_valid = (d2 >= SENSOR_MIN_VALID_DIST_CM && d2 <= SENSOR_MAX_VALID_DIST_CM);
    } else {
        currentData.sensor_2_valid = false;
    }
    
    float fusedDistanceCm = 0.0f;
    
    if (currentData.sensor_1_valid && currentData.sensor_2_valid) {
        currentData.sensor_delta_cm = fabsf(d1 - d2);
        
        // --- Step 3: Sensor Voting & Agreement Check ---
        if (currentData.sensor_delta_cm <= SENSOR_MAX_DELTA_CM) {
            // Both agree within 5.0 cm: High-confidence average
            fusedDistanceCm = (d1 + d2) * 0.5f;
            currentData.sensors_in_agreement = true;
            currentData.degraded_mode = false;
            currentData.critical_sensor_fault = false;
        } else {
            // Divergence > 5.0 cm: Industrial Fail-Safe Principle (High-Water Priority)
            // Whichever sensor detects the closer obstacle / higher water level takes precedence: min(d1, d2).
            // This guarantees that BOTH Sensor 1 AND Sensor 2 can independently trigger emergency gate relief!
            fusedDistanceCm = (d1 < d2) ? d1 : d2;
            currentData.sensors_in_agreement = false;
            currentData.degraded_mode = true;
            currentData.critical_sensor_fault = false;
        }
    } else if (currentData.sensor_1_valid) {
        // Operating cleanly on Primary Sensor 1
        fusedDistanceCm = d1;
        currentData.sensor_delta_cm = 0.0f;
        currentData.sensors_in_agreement = (activeSensorCount == 1);
        currentData.degraded_mode = (activeSensorCount > 1);
        currentData.critical_sensor_fault = false;
    } else if (currentData.sensor_2_valid) {
        // Fallback to Sensor 2
        fusedDistanceCm = d2;
        currentData.sensor_delta_cm = 999.0f;
        currentData.sensors_in_agreement = false;
        currentData.degraded_mode = true;
        currentData.critical_sensor_fault = false;
    } else {
        // Both sensors gave no usable reading this cycle.
        // FIX: one bad cycle (splash, cross-talk) no longer raises a fault + SMS; only
        // SENSOR_FAULT_CONFIRM_CYCLES failures in a row do. The last level is kept meanwhile.
        currentData.sensors_in_agreement = false;
        currentData.degraded_mode = true;
        if (consecutiveFailCycles < 255) consecutiveFailCycles++;
        // previousSampleTimeMs == 0 means there has never been a good reading since boot, so there
        // is no "last level" to keep: report the fault at once instead of a default 0% (which
        // would make AUTO mode close a gate that was open before the reboot).
        currentData.critical_sensor_fault = (consecutiveFailCycles >= SENSOR_FAULT_CONFIRM_CYCLES) ||
                                            (previousSampleTimeMs == 0);
        return currentData;
    }
    consecutiveFailCycles = 0;
    
    // --- Step 4: Water Level Calculation ---
    // Water Depth = Total Height from Tank Floor to Sensor - Measured Distance
    float calculatedDepthCm = SENSOR_MOUNT_HEIGHT_CM - fusedDistanceCm;
    if (calculatedDepthCm < 0.0f) calculatedDepthCm = 0.0f;
    if (calculatedDepthCm > TANK_MAX_DEPTH_CM) calculatedDepthCm = TANK_MAX_DEPTH_CM;
    
    // --- Step 5: Rate of Change Plausibility Filter ---
    if (previousSampleTimeMs > 0) {
        float dtSeconds = (now - previousSampleTimeMs) / 1000.0f;
        if (dtSeconds > 0.1f) {
            float deltaLevel = calculatedDepthCm - previousWaterLevelCm;
            float rateCmPerSec = fabsf(deltaLevel) / dtSeconds;
            currentData.rate_of_change_cm_s = rateCmPerSec;
            
            // If rate of change exceeds physical maximum (water slosh / foreign object), dampen spike
            if (rateCmPerSec > SENSOR_MAX_RATE_CM_PER_S) {
                // Apply exponential low-pass filter (90% previous, 10% new)
                calculatedDepthCm = (previousWaterLevelCm * 0.90f) + (calculatedDepthCm * 0.10f);
            }
        }
    }
    
    currentData.water_level_cm = calculatedDepthCm;
    currentData.water_level_pct = (calculatedDepthCm / TANK_MAX_DEPTH_CM) * 100.0f;
    if (currentData.water_level_pct > 100.0f) currentData.water_level_pct = 100.0f;
    
    previousWaterLevelCm = calculatedDepthCm;
    previousSampleTimeMs = now;
    
    return currentData;
}
