blacksnake200212-del/FYP_2026/firmware/SDAS_ESP32_Firmware/sensors.h

#ifndef SDAS_SENSORS_H
#define SDAS_SENSORS_H

#include <Arduino.h>
#include "config.h"

struct SensorData {
    float raw_dist_1_cm;
    float raw_dist_2_cm;
    bool  sensor_1_valid;
    bool  sensor_2_valid;
    float sensor_delta_cm;
    bool  sensors_in_agreement;
    
    float temperature_c;
    float humidity_pct;
    bool  dht_valid;           // FIX: false when the DHT22 has not given a good reading recently
    float speed_of_sound_mps;
    
    float water_level_cm;
    float water_level_pct;
    float rate_of_change_cm_s;
    
    bool  degraded_mode;       // True if operating on single sensor fallback
    bool  critical_sensor_fault; // True if both sensors fail plausibility
    unsigned long timestamp_ms;
};

class SensorManager {
public:
    SensorManager();
    void begin();
    SensorData sampleAndVerify();
    float getLastWaterLevelPct() const { return currentData.water_level_pct; }
    const SensorData& getData() const { return currentData; }
    
    // Dynamic Sensor Count Control (Single vs Dual)
    void setSensorCount(uint8_t count);
    uint8_t getSensorCount() const { return activeSensorCount; }
    void testRawPing();

private:
    uint8_t activeSensorCount;
    SensorData currentData;
    float previousWaterLevelCm;
    unsigned long previousSampleTimeMs;
    uint8_t consecutiveFailCycles;   // FIX: both-sensor failures in a row (fault debounce)
    unsigned long lastDhtOkMs;        // FIX: time of last checksum-valid DHT22 reading

    float measureSingleUltrasonic(uint8_t trigPin, uint8_t echoPin, float speedOfSound);
    float measureFilteredUltrasonic(uint8_t trigPin, uint8_t echoPin, float speedOfSound);
    void readDHTSensors();
    float calculateSpeedOfSound(float tempC);
};

#endif // SDAS_SENSORS_H
