blacksnake200212-del/FYP_2026/wokwi_simulation/sketch/sketch.ino

// ============================================================================
// SMART DAM ALERT SYSTEM WITH AUTOMATED GATE CONTROL (SDAS)
// Wokwi Hardware Simulation Firmware V2.1 (Optimized for Interactive Testing)
// Audited Hardware Blueprint & Pinout for ESP32 DevKit V1
// Lead Authors: Dias Adrian, AAA Aadhil, JMRA Dilshan
// Faculty of Computing and IT, SLTC Research University
// ============================================================================

#include <Arduino.h>
#include <WiFi.h>
#include <HTTPClient.h>
#include <WiFiClientSecure.h>
#include <ArduinoJson.h>
#include <ESP32Servo.h>
#include <DHT.h>

// ----------------------------------------------------------------------------
// PIN CONFIGURATION (Audited Blueprint V2.0)
// ----------------------------------------------------------------------------
#define PIN_TRIG_1           5     // JSN-SR04T #1 Trigger
#define PIN_ECHO_1           19    // JSN-SR04T #1 Echo
#define PIN_TRIG_2           18    // JSN-SR04T #2 Trigger
#define PIN_ECHO_2           21    // JSN-SR04T #2 Echo

#define PIN_DHT              4     // DHT22 Ambient Sensor (Temp/Humidity)
#define DHTTYPE              DHT22

#define PIN_SERVO            25    // MG90S Sluice Gate Servo PWM (same as the real build)
#define PIN_BUZZER           27    // BC547 Driven 5V Buzzer

#define PIN_LED_RED          32    // RGB LED - Red Cathode (Active LOW)
#define PIN_LED_GREEN        33    // RGB LED - Green Cathode (Active LOW)
#define PIN_LED_BLUE         13    // RGB LED - Blue Cathode (Active LOW)

#define PIN_BTN_OPEN         14    // Manual OPEN Button (Active LOW)
#define PIN_BTN_CLOSE        26    // Manual CLOSE Button (Active LOW)
#define PIN_BTN_STOP         22    // Emergency E-STOP Button (Active LOW)

// ----------------------------------------------------------------------------
// TANK GEOMETRY & HYDRAULIC THRESHOLDS
// ----------------------------------------------------------------------------
const float SENSOR_MOUNT_HEIGHT_CM = 50.0f; // Sensor to tank floor (same as firmware config.h)
const float TANK_MAX_DEPTH_CM      = 40.0f; // Max usable depth (100% full)
const float SENSOR_MAX_DELTA_CM    = 5.0f;  // Plausibility divergence threshold

// 4-Tier Disaster Alert Percentages
// Level >= 85%  -> DANGER (Gate opens to 50% / 90 deg)
// Level >= 80%  -> CLEAR AREA (Gate opens to 20% / 36 deg)
// Level >= 60%  -> PRE-WARNING (Gate held closed 0% to conserve water)
// Level < 60%   -> NORMAL (Gate closed 0%)
const float THRESH_NORMAL_PCT      = 60.0f;
const float THRESH_PREWARN_PCT     = 60.0f;
const float THRESH_CLEARAREA_PCT   = 80.0f;
const float THRESH_DANGER_PCT      = 85.0f;

// 3% Hysteresis Margins (Prevents rapid flapping)
const float HYSTERESIS_PCT         = 3.0f;
const float EXIT_PREWARN_PCT       = (THRESH_PREWARN_PCT - HYSTERESIS_PCT);    // 57.0%
const float EXIT_CLEARAREA_PCT     = (THRESH_CLEARAREA_PCT - HYSTERESIS_PCT);  // 77.0%
const float EXIT_DANGER_PCT        = (THRESH_DANGER_PCT - HYSTERESIS_PCT);     // 82.0%

// Sluice Gate Positions (% and Servo Degrees - Only 20% and 50% needed)
const int GATE_PCT_CLOSED          = 0;    // 0% - Fully closed (0 deg)
const int GATE_PCT_CLEAR_AREA      = 20;   // 20% - Advisory release (36 deg)
const int GATE_PCT_DANGER          = 50;   // 50% - Emergency release (90 deg)
const int GATE_PCT_MAX_LIMIT       = 50;   // 50% - Maximum allowable open limit

// Watchdog Timeout (reverts to AUTO after 60s in simulation)
const unsigned long MANUAL_WATCHDOG_MS = 60000;

// ----------------------------------------------------------------------------
// ENUMS & STATE STRUCTURES
// ----------------------------------------------------------------------------
enum AlertState {
    STATE_NORMAL,
    STATE_PRE_WARNING,
    STATE_CLEAR_AREA,
    STATE_DANGER,
    STATE_SENSOR_FAULT
};

enum ControlMode {
    MODE_AUTO,
    MODE_MANUAL,
    MODE_EMERGENCY
};

enum BuzzerCadence {
    BUZZ_OFF,
    BUZZ_CHIRP,
    BUZZ_PULSE,
    BUZZ_SIREN
};

// ----------------------------------------------------------------------------
// GLOBAL OBJECTS & STATE VARIABLES
// ----------------------------------------------------------------------------
DHT dht(PIN_DHT, DHTTYPE);
Servo gateServo;

AlertState    currentAlertState    = STATE_NORMAL;
AlertState    previousAlertState   = STATE_NORMAL;
ControlMode   currentControlMode   = MODE_AUTO;
BuzzerCadence currentBuzzerCadence = BUZZ_OFF;

float currentWaterLevelPct = 0.0f;
float currentTempC         = 28.5f;
float currentHumidityPct   = 75.0f;
float sensor1DistCm        = 45.0f;
float sensor2DistCm        = 45.0f;
bool  sensorsAgreed        = true;
bool  degradedModeActive   = false;

int   targetGatePercent    = 0;
int   actualGatePercent    = 0;
float currentServoAngle    = 0.0f;
float targetServoAngle     = 0.0f;

unsigned long lastSensorSampleMs   = 0;
unsigned long lastTelemetrySyncMs  = 0;
unsigned long lastBuzzerToggleMs   = 0;
unsigned long manualModeTimeoutMs  = 0;
bool          buzzerOutputState    = false;

// Emergency Contacts for SMS Dispatch (Configured with User Testing Numbers)
const char* CONTACT_OPERATOR = "+94740099235"; // Testing Number 1 (Adrian)
const char* CONTACT_DMC      = "+94712833936"; // Testing Number 2 (Aadhil)
const char* CONTACT_DS       = "+94781099235"; // Testing Number 3 (Dilshan)

// Live Render ML Backend
const char* CLOUD_TELEMETRY_URL = "https://sdas-ml-backend.onrender.com/api/v1/telemetry-hook";

// ----------------------------------------------------------------------------
// HARDWARE DRIVER FUNCTIONS
// ----------------------------------------------------------------------------

// Active-LOW RGB LED Helper for Common Anode
void setRGB(bool red, bool green, bool blue) {
    digitalWrite(PIN_LED_RED,   red   ? LOW : HIGH);
    digitalWrite(PIN_LED_GREEN, green ? LOW : HIGH);
    digitalWrite(PIN_LED_BLUE,  blue  ? LOW : HIGH);
}

void updateAlertLED(AlertState state) {
    switch (state) {
        case STATE_NORMAL:
            setRGB(false, true, false);  // Pure Green
            break;
        case STATE_PRE_WARNING:
            setRGB(true, true, false);   // Yellow (Red + Green)
            break;
        case STATE_CLEAR_AREA:
            setRGB(true, true, false);   // Orange / Amber
            break;
        case STATE_DANGER:
            setRGB(true, false, false);  // Pure Red
            break;
        case STATE_SENSOR_FAULT:
            setRGB(true, false, true);   // Magenta (Red + Blue)
            break;
    }
}

// Ultrasonic Pulse Measurement with Acoustic Velocity Compensation
float measureAcousticDistance(uint8_t trigPin, uint8_t echoPin, float soundSpeedMps) {
    digitalWrite(trigPin, LOW);
    delayMicroseconds(2);
    digitalWrite(trigPin, HIGH);
    delayMicroseconds(10);
    digitalWrite(trigPin, LOW);

    long durationUs = pulseIn(echoPin, HIGH, 50000); // 50ms timeout (~8.5m)
    // FIX: no echo used to return the tank baseline (= "empty tank, NORMAL"), which hid a dead
    // or unplugged sensor. Like the real firmware, no echo is now INVALID (-1).
    if (durationUs <= 0) return -1.0f;

    // Distance = (Velocity * time) / 2
    // Velocity in m/s -> cm/us = (m/s) / 10,000
    float distanceCm = ((float)durationUs * soundSpeedMps) / 20000.0f;
    return distanceCm;
}

// Servo Gate Actuation with Immediate Visual Feedback
void applyGatePosition(int percent) {
    targetGatePercent = constrain(percent, 0, 100);
    targetServoAngle = ((float)targetGatePercent / 100.0f) * 180.0f;
    gateServo.write((int)targetServoAngle);
    actualGatePercent = targetGatePercent;
    currentServoAngle = targetServoAngle;
}

// Buzzer Cadence Driver
void updateBuzzer(unsigned long now) {
    switch (currentBuzzerCadence) {
        case BUZZ_OFF:
            digitalWrite(PIN_BUZZER, LOW);
            buzzerOutputState = false;
            break;

        case BUZZ_CHIRP:
            // Single 100ms chirp every 4000ms
            if ((now % 4000) < 100) {
                digitalWrite(PIN_BUZZER, HIGH);
            } else {
                digitalWrite(PIN_BUZZER, LOW);
            }
            break;

        case BUZZ_PULSE:
            // Intermittent warning: 400ms ON / 400ms OFF
            if (now - lastBuzzerToggleMs >= 400) {
                lastBuzzerToggleMs = now;
                buzzerOutputState = !buzzerOutputState;
                digitalWrite(PIN_BUZZER, buzzerOutputState ? HIGH : LOW);
            }
            break;

        case BUZZ_SIREN:
            // Rapid emergency siren: 150ms ON / 100ms OFF
            unsigned long phase = now % 250;
            if (phase < 150) {
                digitalWrite(PIN_BUZZER, HIGH);
            } else {
                digitalWrite(PIN_BUZZER, LOW);
            }
            break;
    }
}

// Simulated SIM800L SMS Dispatch
void dispatchEmergencySMS(const char* recipient, const char* message) {
    Serial.println("\n---------------------------------------------------------");
    Serial.printf("[GSM-MODEM] AT+CMGS=\"%s\"\n", recipient);
    Serial.printf("[GSM-MODEM] > %s\n", message);
    Serial.println("[GSM-MODEM] SMS DISPATCHED SUCCESSFULLY [OK]");
    Serial.println("---------------------------------------------------------");
}

void broadcastAlertSms(AlertState state, float levelPct) {
    char msg[160];
    if (state == STATE_DANGER) {
        snprintf(msg, sizeof(msg),
            "CRITICAL DANGER: Tabbowa Dam reservoir at %.1f%%. Auto-gate opened to 50%%. Initiate riverbank evacuation!",
            levelPct);
        dispatchEmergencySMS(CONTACT_OPERATOR, msg);
        dispatchEmergencySMS(CONTACT_DMC, msg);
        dispatchEmergencySMS(CONTACT_DS, msg);
    } else if (state == STATE_PRE_WARNING) {
        snprintf(msg, sizeof(msg),
            "SDAS ADVISORY: Tabbowa Dam at %.1f%%. Pre-warning threshold reached. Gate held closed to conserve water.",
            levelPct);
        dispatchEmergencySMS(CONTACT_OPERATOR, msg);
    }
}

// ----------------------------------------------------------------------------
// DISASTER FINITE STATE MACHINE (FSM) WITH 3% HYSTERESIS
// ----------------------------------------------------------------------------
void applyAutoGateForState(AlertState state) {
    switch (state) {
        case STATE_NORMAL:
            applyGatePosition(GATE_PCT_CLOSED); // 0%
            currentBuzzerCadence = BUZZ_OFF;
            break;
        case STATE_PRE_WARNING:
            applyGatePosition(GATE_PCT_CLOSED); // 0% - conserve water
            currentBuzzerCadence = BUZZ_CHIRP;
            break;
        case STATE_CLEAR_AREA:
            applyGatePosition(GATE_PCT_CLEAR_AREA); // 20% release (36 deg)
            currentBuzzerCadence = BUZZ_PULSE;
            break;
        case STATE_DANGER:
            applyGatePosition(GATE_PCT_DANGER); // 50% emergency release (90 deg)
            currentBuzzerCadence = BUZZ_SIREN;
            break;
        case STATE_SENSOR_FAULT:
            applyGatePosition(GATE_PCT_CLOSED);
            currentBuzzerCadence = BUZZ_PULSE;
            break;
    }
}

void evaluateStateMachine(float levelPct) {
    if (currentControlMode == MODE_EMERGENCY || currentControlMode == MODE_MANUAL) {
        // Operator manual control takes precedence!
        return;
    }

    AlertState nextState = currentAlertState;

    // FSM State Transition Logic with 3% Hysteresis
    switch (currentAlertState) {
        case STATE_NORMAL:
            if (levelPct >= THRESH_DANGER_PCT) {
                nextState = STATE_DANGER;
            } else if (levelPct >= THRESH_CLEARAREA_PCT) {
                nextState = STATE_CLEAR_AREA;
            } else if (levelPct >= THRESH_PREWARN_PCT) {
                nextState = STATE_PRE_WARNING;
            }
            break;

        case STATE_PRE_WARNING:
            if (levelPct >= THRESH_DANGER_PCT) {
                nextState = STATE_DANGER;
            } else if (levelPct >= THRESH_CLEARAREA_PCT) {
                nextState = STATE_CLEAR_AREA;
            } else if (levelPct < EXIT_PREWARN_PCT) {
                nextState = STATE_NORMAL;
            }
            break;

        case STATE_CLEAR_AREA:
            if (levelPct >= THRESH_DANGER_PCT) {
                nextState = STATE_DANGER;
            } else if (levelPct < EXIT_CLEARAREA_PCT) {
                nextState = (levelPct >= THRESH_PREWARN_PCT) ? STATE_PRE_WARNING : STATE_NORMAL;
            }
            break;

        case STATE_DANGER:
            if (levelPct < EXIT_DANGER_PCT) {
                nextState = (levelPct >= THRESH_CLEARAREA_PCT) ? STATE_CLEAR_AREA : STATE_PRE_WARNING;
            }
            break;

        case STATE_SENSOR_FAULT:
            // FIX: recovery evaluates the real level (used to jump straight to NORMAL at 60-79%)
            if (levelPct >= THRESH_DANGER_PCT) {
                nextState = STATE_DANGER;
            } else if (levelPct >= THRESH_CLEARAREA_PCT) {
                nextState = STATE_CLEAR_AREA;
            } else if (levelPct >= THRESH_PREWARN_PCT) {
                nextState = STATE_PRE_WARNING;
            } else {
                nextState = STATE_NORMAL;
            }
            break;
    }

    // State Entry Actions & Automatic Gate Actuation
    if (nextState != currentAlertState) {
        Serial.printf("\n[FSM] State Transition: %d -> %d (Level: %.1f%%)\n",
            currentAlertState, nextState, levelPct);
        
        previousAlertState = currentAlertState;
        currentAlertState  = nextState;

        if (currentControlMode == MODE_AUTO) {
            applyAutoGateForState(currentAlertState);
            switch (currentAlertState) {
                case STATE_NORMAL:
                    Serial.println(">>> GATE CLOSED (0% - Normal Level) <<<");
                    break;
                case STATE_PRE_WARNING:
                    broadcastAlertSms(STATE_PRE_WARNING, levelPct);
                    Serial.println(">>> PRE-WARNING ACTIVE: Gate Held Closed (0%) to Conserve Water <<<");
                    break;
                case STATE_CLEAR_AREA:
                    Serial.println("\n*******************************************************");
                    Serial.println(">>> GATE OPENED TO 20% (CLEAR AREA WARNING - 36 deg) <<<");
                    Serial.println("*******************************************************");
                    break;
                case STATE_DANGER:
                    broadcastAlertSms(STATE_DANGER, levelPct);
                    Serial.println("\n*******************************************************");
                    Serial.println(">>> CRITICAL DANGER! GATE OPENED TO 50% (90 deg) <<<");
                    Serial.println("*******************************************************");
                    break;
                case STATE_SENSOR_FAULT:
                    break;
            }
        }
    }

    if (degradedModeActive && currentAlertState != STATE_DANGER && currentAlertState != STATE_CLEAR_AREA) {
        updateAlertLED(STATE_SENSOR_FAULT);
    } else {
        updateAlertLED(currentAlertState);
    }
}

// ----------------------------------------------------------------------------
// CLOUD TELEMETRY & AI INFERENCE SYNCHRONIZATION
// ----------------------------------------------------------------------------
void syncCloudTelemetry() {
    if (WiFi.status() != WL_CONNECTED) return;

    WiFiClientSecure client;
    client.setInsecure(); // Bypass SSL verification in simulation
    HTTPClient http;
    http.setTimeout(1500); // Fast non-blocking timeout

    if (http.begin(client, CLOUD_TELEMETRY_URL)) {
        http.addHeader("Content-Type", "application/json");

        StaticJsonDocument<256> doc;
        doc["water_level_pct"]   = round(currentWaterLevelPct * 10.0f) / 10.0f;
        doc["sensor_1_dist_cm"]  = round(sensor1DistCm * 10.0f) / 10.0f;
        doc["sensor_2_dist_cm"]  = round(sensor2DistCm * 10.0f) / 10.0f;
        doc["temperature_c"]     = round(currentTempC * 10.0f) / 10.0f;
        doc["humidity_pct"]      = round(currentHumidityPct * 10.0f) / 10.0f;
        doc["gate_percent"]      = actualGatePercent;
        doc["rainfall_mm"]       = 0.0;

        String requestBody;
        serializeJson(doc, requestBody);

        int httpCode = http.POST(requestBody);
        if (httpCode == 200) {
            String response = http.getString();
            StaticJsonDocument<512> resDoc;
            deserializeJson(resDoc, response);

            Serial.println("\n[CLOUD-AI] Telemetry Synchronized to Render Backend:");
            const char* verdict = resDoc["anomaly_analysis"]["anomaly_verdict"];
            const char* risk    = resDoc["risk_classification"]["hazard_label"];
            float conf          = resDoc["risk_classification"]["confidence_score"];

            Serial.printf("  > Autoencoder Anomaly Verdict : %s\n", verdict ? verdict : "OK");
            Serial.printf("  > Random Forest Hazard Class  : %s (Conf: %.1f%%)\n", risk ? risk : "NORMAL", conf * 100.0f);
        }
        http.end();
    }
}

// ----------------------------------------------------------------------------
// MANUAL BUTTONS & SAFETY WATCHDOG
// ----------------------------------------------------------------------------
void handleButtons() {
    int readStop  = digitalRead(PIN_BTN_STOP);
    int readOpen  = digitalRead(PIN_BTN_OPEN);
    int readClose = digitalRead(PIN_BTN_CLOSE);

    static int prevStop  = HIGH;
    static int prevOpen  = HIGH;
    static int prevClose = HIGH;

    // 1. Emergency STOP (GPIO22 / Key: S)
    if (readStop == LOW && prevStop == HIGH) {
        if (currentControlMode == MODE_EMERGENCY) {
            currentControlMode = MODE_AUTO;
            applyAutoGateForState(currentAlertState);
            updateAlertLED(currentAlertState);
            Serial.println("\n>>> [E-STOP CLEARED] Returning to Autonomous Control (AUTO) <<<");
        } else {
            currentControlMode = MODE_EMERGENCY;
            currentBuzzerCadence = BUZZ_SIREN;
            Serial.println("\n*******************************************************");
            Serial.println(">>> [CRITICAL] EMERGENCY STOP PRESSED! Gate Frozen in Position <<<");
            Serial.println("*******************************************************");
        }
    }

    // Safety Interlock: Block manual actions if Emergency Stop is active
    if (currentControlMode == MODE_EMERGENCY) {
        if ((readOpen == LOW && prevOpen == HIGH) || (readClose == LOW && prevClose == HIGH)) {
            Serial.println("\n[MANUAL LOCKED] E-STOP is active! Click Red Button or press 'S' to release E-STOP first.");
        }
    } else {
        // 2. Manual CLOSE Button (GPIO26 / Key: C) -> Stepped Gate Closure (50% -> 20% -> 0%)
        if (readClose == LOW && prevClose == HIGH) {
            currentControlMode = MODE_MANUAL;
            manualModeTimeoutMs = millis() + MANUAL_WATCHDOG_MS;
            int targetPct = (actualGatePercent > 20) ? 20 : 0;
            applyGatePosition(targetPct);
            Serial.println("\n=======================================================");
            if (targetPct == 0) {
                Serial.println(">>> [MANUAL] CLOSE PRESSED -> Sluice Gate FULLY CLOSED (0% / 0 deg) <<<");
            } else {
                Serial.printf(">>> [MANUAL] CLOSE PRESSED -> Sluice Gate Stepped Down to %d%% (%d deg) <<<\n", targetPct, (int)currentServoAngle);
            }
            Serial.printf("     Manual mode active. Auto-watchdog reverts in %lu seconds.\n", MANUAL_WATCHDOG_MS / 1000);
            Serial.println("=======================================================");
        }

        // 3. Manual OPEN Button (GPIO14 / Key: O) -> Stepped Gate Opening (0% -> 20% -> 50% Max)
        if (readOpen == LOW && prevOpen == HIGH) {
            currentControlMode = MODE_MANUAL;
            manualModeTimeoutMs = millis() + MANUAL_WATCHDOG_MS;
            int targetPct = (actualGatePercent < 20) ? 20 : 50;
            applyGatePosition(targetPct);
            Serial.println("\n=======================================================");
            if (actualGatePercent >= 50) {
                Serial.printf(">>> [MANUAL] OPEN PRESSED -> Sluice Gate Set to %d%% (%d deg - MAXIMUM LIMIT) <<<\n", targetPct, (int)currentServoAngle);
            } else {
                Serial.printf(">>> [MANUAL] OPEN PRESSED -> Sluice Gate OPENED TO %d%% (%d deg) <<<\n", targetPct, (int)currentServoAngle);
            }
            Serial.printf("     Manual mode active. Auto-watchdog reverts in %lu seconds.\n", MANUAL_WATCHDOG_MS / 1000);
            Serial.println("=======================================================");
        }
    }

    prevStop  = readStop;
    prevOpen  = readOpen;
    prevClose = readClose;

    // 4. Manual Mode Safety Watchdog - Revert to AUTO after 60s
    if (currentControlMode == MODE_MANUAL) {
        if (millis() > manualModeTimeoutMs) {
            Serial.printf("\n[WATCHDOG] Manual override timed out (%lu s). Reverting to autonomous regulation.\n", MANUAL_WATCHDOG_MS / 1000);
            currentControlMode = MODE_AUTO;
            applyAutoGateForState(currentAlertState);
            updateAlertLED(currentAlertState);
        }
    }
}

// ----------------------------------------------------------------------------
// ARDUINO SETUP & INITIALIZATION
// ----------------------------------------------------------------------------
void setup() {
    Serial.begin(115200);
    delay(500);

    Serial.println("\n=======================================================");
    Serial.println("  SMART DAM ALERT SYSTEM (SDAS) - WOKWI SIMULATOR V2.1");
    Serial.println("  Target Hardware: ESP32 DevKit V1 | Blueprint V2.0");
    Serial.println("=======================================================");

    // 1. Actuators & Indicators Setup
    pinMode(PIN_LED_RED,   OUTPUT);
    pinMode(PIN_LED_GREEN, OUTPUT);
    pinMode(PIN_LED_BLUE,  OUTPUT);
    setRGB(false, false, false);

    pinMode(PIN_BUZZER, OUTPUT);
    digitalWrite(PIN_BUZZER, LOW);

    // Standard ESP32Servo Setup
    ESP32PWM::allocateTimer(0);
    ESP32PWM::allocateTimer(1);
    ESP32PWM::allocateTimer(2);
    ESP32PWM::allocateTimer(3);
    gateServo.setPeriodHertz(50);
    gateServo.attach(PIN_SERVO, 500, 2400);
    applyGatePosition(0);

    // 2. Sensors Setup
    pinMode(PIN_TRIG_1, OUTPUT);
    pinMode(PIN_ECHO_1, INPUT);
    pinMode(PIN_TRIG_2, OUTPUT);
    pinMode(PIN_ECHO_2, INPUT);
    dht.begin();

    // 3. Manual Buttons Setup
    pinMode(PIN_BTN_OPEN,  INPUT_PULLUP);
    pinMode(PIN_BTN_CLOSE, INPUT_PULLUP);
    pinMode(PIN_BTN_STOP,  INPUT_PULLUP);

    Serial.println("\n[MANUAL CONTROLS & OPERATOR OVERRIDE READY]");
    Serial.printf("  > OPEN  [GPIO%d] : Click Green Button or Press 'O' Key -> Steps 0%% -> 20%% -> 50%% (MAX)\n", PIN_BTN_OPEN);
    Serial.printf("  > CLOSE [GPIO%d] : Click Grey Button  or Press 'C' Key -> Steps 50%% -> 20%% -> 0%% (CLOSED)\n", PIN_BTN_CLOSE);
    Serial.printf("  > E-STOP[GPIO%d] : Click Red Button   or Press 'S' Key -> FREEZE GATE & EMERGENCY SIREN\n", PIN_BTN_STOP);
    Serial.println("  > SERIAL COMMANDS: Type 20, 50, 0, OPEN, CLOSE, AUTO, or STOP in Serial Monitor\n");

    // 4. Connect to Wokwi Simulated Wi-Fi (Non-blocking)
    Serial.println("[WIFI] Connecting to Wokwi Virtual Gateway in background...");
    WiFi.begin("Wokwi-GUEST", "");

    Serial.println("[SDAS] Hardware initialization completed.\n");
}

// ----------------------------------------------------------------------------
// MAIN EXECUTION LOOP
// ----------------------------------------------------------------------------
void loop() {
    unsigned long now = millis();

    // 1. High-Frequency Fast Loop - Buzzer Cadence & Physical Buttons
    updateBuzzer(now);
    handleButtons();

    // 2. Sensor Sampling & FSM Processing Loop (Every 2.0 Seconds)
    if (now - lastSensorSampleMs >= 2000) {
        lastSensorSampleMs = now;

        // A. Read DHT22
        float t = dht.readTemperature();
        float h = dht.readHumidity();
        if (!isnan(t)) currentTempC = t;
        if (!isnan(h)) currentHumidityPct = h;

        // B. Acoustic Sound Speed Compensation Formula
        // v = 331.4 + 0.606 * Temp + 0.0124 * Humidity
        float soundSpeed = 331.4f + (0.606f * currentTempC) + (0.0124f * currentHumidityPct);

        // C. Read Dual Ultrasonic Sensors (Alternating pings to avoid cross-talk)
        sensor1DistCm = measureAcousticDistance(PIN_TRIG_1, PIN_ECHO_1, soundSpeed);
        delay(40); // 40ms acoustic decay margin
        sensor2DistCm = measureAcousticDistance(PIN_TRIG_2, PIN_ECHO_2, soundSpeed);

        // D. Smart Sensor Fusion & Plausibility Engine
        // A reading counts as valid if there was an echo (> 0). In Wokwi, a sensor left at its
        // default distance (beyond the 50 cm mount) is treated as "not in use" so you can drive the
        // level with one slider. No echo on BOTH sensors = SENSOR FAULT (as in the real firmware).
        bool v1 = sensor1DistCm > 0.0f;
        bool v2 = sensor2DistCm > 0.0f;
        bool inTank1 = v1 && sensor1DistCm <= SENSOR_MOUNT_HEIGHT_CM;
        bool inTank2 = v2 && sensor2DistCm <= SENSOR_MOUNT_HEIGHT_CM;
        float effectiveDist = SENSOR_MOUNT_HEIGHT_CM;
        bool levelValid = true;

        if (!v1 && !v2) {
            levelValid = false;
        } else if (inTank1 && !inTank2) {
            effectiveDist = sensor1DistCm;
            sensorsAgreed = v2 ? false : true;
            degradedModeActive = !v2;
        } else if (inTank2 && !inTank1) {
            effectiveDist = sensor2DistCm;
            sensorsAgreed = v1 ? false : true;
            degradedModeActive = !v1;
        } else if (v1 && v2) {
            float delta = fabsf(sensor1DistCm - sensor2DistCm);
            if (delta <= SENSOR_MAX_DELTA_CM || (!inTank1 && !inTank2)) {
                sensorsAgreed = true;
                degradedModeActive = false;
                effectiveDist = min((sensor1DistCm + sensor2DistCm) / 2.0f, SENSOR_MOUNT_HEIGHT_CM);
            } else {
                sensorsAgreed = false;
                degradedModeActive = true;
                // Conservative fail-safe: use the sensor detecting higher water
                effectiveDist = min(sensor1DistCm, sensor2DistCm);
                Serial.printf("[WARNING] Sensor Divergence! S1=%.1fcm, S2=%.1fcm (Delta=%.1fcm > 5cm)\n",
                    sensor1DistCm, sensor2DistCm, delta);
            }
        } else {
            // Only one sensor answers and it reads beyond the tank: use it, flag degraded
            effectiveDist = v1 ? min(sensor1DistCm, SENSOR_MOUNT_HEIGHT_CM) : min(sensor2DistCm, SENSOR_MOUNT_HEIGHT_CM);
            sensorsAgreed = false;
            degradedModeActive = true;
        }

        if (!levelValid) {
            // FIX: both sensors silent -> the level is unknown. Enter SENSOR FAULT instead of
            // reporting an empty tank. Operator control (MANUAL / E-STOP) is not overridden.
            sensorsAgreed = false;
            degradedModeActive = true;
            if (currentControlMode == MODE_AUTO && currentAlertState != STATE_SENSOR_FAULT) {
                Serial.println("[FAULT] No echo from BOTH ultrasonic sensors - water level unknown!");
                previousAlertState = currentAlertState;
                currentAlertState = STATE_SENSOR_FAULT;
                applyAutoGateForState(STATE_SENSOR_FAULT);
            }
            updateAlertLED(STATE_SENSOR_FAULT);
            Serial.println("[SDAS TELEMETRY] Water Level: UNKNOWN | State: SENSOR FAULT (check HC-SR04 wiring / 5V power)");
        } else {

        // E. Compute Reservoir Water Level %
        // Depth = Mount Height (50cm) - Measured Distance
        // % = (Depth / Max Usable Depth (40cm)) * 100
        float depthCm = SENSOR_MOUNT_HEIGHT_CM - effectiveDist;
        currentWaterLevelPct = constrain((depthCm / TANK_MAX_DEPTH_CM) * 100.0f, 0.0f, 100.0f);

        // F. Run Finite State Machine Evaluation
        evaluateStateMachine(currentWaterLevelPct);

        // G. Telemetry Dashboard Output
        const char* stateNames[] = { "NORMAL", "PRE-WARNING", "CLEAR AREA", "DANGER", "FAULT" };
        const char* modeNames[]  = { "AUTO", "MANUAL", "EMERGENCY" };

        Serial.printf("\n[SDAS TELEMETRY] Water Level: %5.1f%% | State: %-11s | Gate: %3d%% (Servo: %3d deg) | Mode: %s\n",
            currentWaterLevelPct,
            stateNames[currentAlertState],
            actualGatePercent,
            (int)currentServoAngle,
            modeNames[currentControlMode]);
        Serial.printf("                 Dist1: %4.1fcm | Dist2: %4.1fcm | Temp: %4.1fC | Humid: %4.1f%%\n",
            sensor1DistCm, sensor2DistCm, currentTempC, currentHumidityPct);
        } // end levelValid
    }

    // 3. Cloud Synchronization Loop (Every 10 Seconds)
    if (now - lastTelemetrySyncMs >= 10000) {
        lastTelemetrySyncMs = now;
        syncCloudTelemetry();
    }

    // 4. Interactive Serial Console Commands
    if (Serial.available()) {
        String cmd = Serial.readStringUntil('\n');
        cmd.trim();
        cmd.toUpperCase();
        if (cmd.length() > 0) {
            if (cmd == "OPEN") {
                currentControlMode = MODE_MANUAL;
                manualModeTimeoutMs = millis() + MANUAL_WATCHDOG_MS;
                int targetPct = (actualGatePercent < 20) ? 20 : 50;
                applyGatePosition(targetPct);
                Serial.printf("\n>>> [SERIAL COMMAND] Sluice Gate Stepped Open to %d%% (%d deg) <<<\n", targetPct, (int)currentServoAngle);
            } else if (cmd == "CLOSE") {
                currentControlMode = MODE_MANUAL;
                manualModeTimeoutMs = millis() + MANUAL_WATCHDOG_MS;
                int targetPct = (actualGatePercent > 20) ? 20 : 0;
                applyGatePosition(targetPct);
                Serial.printf("\n>>> [SERIAL COMMAND] Sluice Gate Stepped Closed to %d%% (%d deg) <<<\n", targetPct, (int)currentServoAngle);
            } else if (cmd == "50") {
                currentControlMode = MODE_MANUAL;
                manualModeTimeoutMs = millis() + MANUAL_WATCHDOG_MS;
                applyGatePosition(50);
                Serial.println("\n>>> [SERIAL COMMAND] Sluice Gate Set to 50% (90 deg - Emergency Flush) <<<");
            } else if (cmd == "20") {
                currentControlMode = MODE_MANUAL;
                manualModeTimeoutMs = millis() + MANUAL_WATCHDOG_MS;
                applyGatePosition(20);
                Serial.println("\n>>> [SERIAL COMMAND] Sluice Gate Set to 20% (36 deg - Advisory Release) <<<");
            } else if (cmd == "0") {
                currentControlMode = MODE_MANUAL;
                manualModeTimeoutMs = millis() + MANUAL_WATCHDOG_MS;
                applyGatePosition(0);
                Serial.println("\n>>> [SERIAL COMMAND] Sluice Gate Fully Closed (0% / 0 deg) <<<");
            } else if (cmd == "AUTO") {
                currentControlMode = MODE_AUTO;
                applyAutoGateForState(currentAlertState);
                updateAlertLED(currentAlertState);
                Serial.println("\n>>> [SERIAL COMMAND] Reverted to Autonomous Control (AUTO) <<<");
            } else if (cmd == "STOP" || cmd == "ESTOP") {
                currentControlMode = MODE_EMERGENCY;
                currentBuzzerCadence = BUZZ_SIREN;
                Serial.println("\n>>> [SERIAL COMMAND] EMERGENCY STOP Activated! Gate Frozen. <<<");
            }
        }
    }
}
