blacksnake200212-del/FYP_2026/(commit log)

2026-10-13 fix(simulation): optimize gate actuation and smart sensor fusion for Wokwi interactive testing
2026-10-13 fix(simulation): enhance manual button handling with edge-triggering and immediate full close
2026-10-13 fix(firmware): enhance physical buttons edge-detection, full-close action, and ESP32 Core 2/3 PWM compatibility
2026-10-13 fix(simulation): enhance manual buttons with instant edge detection, zero debounce delay, and keyboard hotkeys (O/C/S)
2026-10-13 fix(simulation): resolve manual OPEN button responsiveness, watchdog restoration and serial commands
2026-10-13 Implement Phase 7: History Charts & AI Inflow Forecasting Insights with SVG trends and sensor integrity
2026-10-14 Correct circuit schematic diagram: eliminate duplicate servo motor and properly wire RGB LED module
2026-10-14 Synchronize test emergency phone numbers across Supabase, ESP32 firmware, and Operator mobile app
2026-10-14 Add complete verified hardware circuit diagram and master CAD schematic
2026-10-14 fix(firmware,hardware): resolve critical firmware bugs, non-blocking FreeRTOS networking, SMS queue, sensor blind zone, and circuit schematics
2026-10-14 refactor(hardware): update actuator specifications from MG996R to MG90S micro metal-gear servo
2026-10-14 fix(sensors,bom): boost JSN-SR04T trigger pulse to 20us and update BOM to MG90S
2026-10-14 refactor(hardware): integrate HC-SR04 ultrasonic sensors and update schematics
2026-10-14 feat(docs): regenerate ultra-crisp master circuit schematic with clean wire corridors
2026-10-14 feat(docs): add Fritzing breadboard pictorial wiring diagram
2026-10-15 feat(hardware): finalize ultra-clear multi-color wire circuit diagram with bench color reference
2026-10-15 feat(hardware): add XL4015 power distribution routing guide and terminal pinout diagram
2026-10-18 feat(database): add INSTEAD OF INSERT trigger on sensor_telemetry view
2026-10-22 feat: complete pixel-perfect design alignment for both Public and Operator apps matching master design board
2026-10-22 feat(apps): integrate DHT22 sensor telemetry, remove public login, and add custom distinct app icons
2026-10-28 fix(firmware): prevent 0.0cm glitch from falsely triggering 100% reservoir blindzone
2026-10-28 feat: add real-time web dashboard for hardware sensor diagnostics with zero mock data
2026-10-28 fix: support Common Cathode RGB LED, enable Pre-Warning SMS trigger, remove degraded LED lockout, and add GSM serial diagnostics
2026-10-28 fix: resolve RGB LED red light lockout, add boot-time cellular registration gate with retry, and add interactive serial diagnostics
2026-10-28 fix: isolate Sensor 2 floating noise lockup, default to Single Sensor Mode on bench, add MUTE/UNMUTE and SENSOR 1/DUAL commands
2026-10-28 feat: add physical button diagnostics (BTN) and boot-safe debounce to fix OPEN, CLOSE, and STOP button lockup
2026-10-28 fix: make CLOSE button immediately close sluice gate to 0% and add 15s operator priority grace period
2026-10-28 fix: add 3-sample median filter, treat open-air timeout as 0% empty reservoir, decouple buzzer from sensor faults, and persist MUTE to flash
2026-10-29 fix: clarify Sensor 2 standby status when running in single-sensor bench test mode
2026-10-29 perf: accelerate servo motion from 1.0 deg/step to brisk 3.0 deg/step (~450ms travel) and reduce ultrasonic timeout to eliminate loop jitter
2026-10-29 feat: enable Dual HC-SR04 ultrasonic sensors (ACTIVE_ULTRASONIC_COUNT 2) with remote SENSOR_2 activation and dashboard toggle
2026-10-29 fix: synchronize RGB LED colors with manual gate discharge stages and add remote LED polarity toggle
2026-10-29 fix(firmware): implement industrial high-water fail-safe priority min(d1, d2) so Sensor 2 moves motor
2026-10-29 fix(control-mode): prevent mode oscillation by disabling bench floating button pins, implementing 250ms hold debounce, and locking operator manual override
2026-10-29 fix(led): configure HW-478 Common Cathode (Active HIGH), instant manual LED update, and direct color test commands
2026-10-29 feat(buttons): re-enable physical push buttons with responsive 40ms debounce and audio-visual feedback
2026-10-29 fix(sensors): expand pulseIn timeout to 24000us (4.1m), lengthen trigger pulse to 15us, and add PING diagnostic command
2026-11-08 fix(hardware): resolve level converter dual-sensor wiring and eliminate auto/manual mode flipping
2026-11-12 fix(network,dashboard): stabilize ESP32 Wi-Fi/TLS reconnect and add MQTT telemetry fallback
2026-11-12 fix(firmware,web,db): add on-device ESP32 HTTP status portal, fix LAN dashboard IP, and merge full project fixes
2026-11-12 fix(firmware): keep ESP32 Wi-Fi hotspot active, add disconnect/reset logging and GSM auto-recovery
2026-11-12 Fix ESP32 Wi-Fi 3s/6s reconnect abort loop and add 2.4GHz scan diagnostics
